shngsk/zmk-config-split-copen/TODO.md

# TODO

## 未解決の問題

なし

## 完了

- [x] **左手デバイス（copen2_L）のキースイッチを押しても何も入力されない**
  - 2026-08-15: 原因判明・解決。
  - **根本原因**: L のバッテリー過放電（電圧 ~1.86V、LiPo 最低動作 3.0V を大幅に下回る）。
    キースキャンは動作するが BLE 広告に必要な大電流を供給できず、L が R に接続できなかった。
  - **対処**: L を USB 給電で使用。バッテリー充電を試みる。回復しない場合はバッテリー交換。
  - **注意**: L が BLE 接続できない場合はまず USB を繋いで動作確認すること。
  - 診断過程で判明した副次的知見:
    - L ハードウェア正常（`copen2_L_standalone` で実機確認済み）
    - `copen2_L.conf` に `CONFIG_BT_CTLR_TX_PWR_PLUS_8=y` を追加（R 側は元々設定済み）

- [x] **USB接続時、Layer 3 の Y キー（BT_SEL 0）を押すと `y` が入力されてしまう**
  - 2026-08-10: 症状改善を確認。完了扱いとする。
  - 右手(copen2_R)のBLE再接続不可の問題を `settings_reset.uf2` 書き込み＋
    PC側の古いペアリング削除で解消した際に、あわせて改善したと思われる
    （詳細な原因切り分けは未実施）。再発したら詳細調査を再開する。
