shngsk/zmk-config-split-copen/(commit log)

2026-01-18 add led config
2026-01-18 Fix board name for Zephyr 4.1.0
2026-01-19 Create right shied's pcb data file
    [copen_right.kicad_pcb, copen_right.kicad_sch]
2026-08-07 Add KiCad PCB design files and update .gitignore
    [EVQWGD001_extension.kicad_pcb, EVQWGD001_extension.kicad_sch, copen_right.kicad_pcb, copen_right.kicad_sch, pmw3610_breakout_for_roBa.kicad_pcb, pmw3610_breakout_for_roBa.kicad_sch, roba_L.kicad_pcb, roba_L.kicad_sch]
2026-08-08 Redesign keymap: mnemonic symbols, numpad, ESC on thumb
    - Layer 0: F16 → lt 4 ESC (tap=ESC, hold=BT layer)
    - Layer 0: Remove layer4_ESC combo; keep S+D=Tab combo
    - Layer 1: テンキー(右手 7-9/4-6/1-3, 0=H) + Fキー(左手 F1-F12)
    DEL = Layer1中にBSタップ
    - Layer 2: ニーモニック記号配置 (Qiita rall_alice 方式)
    @=A !!=E "=W #=H $=D %=P &=N '=Q ¥=Y \=B ;=S :=C
    ~=T `=G |=V {}=MN ()=UI []=JK +-=L;
    - Layer 3: ナビ・Mac ウィンドウ操作 (変更なし)
    - Layer 4: BT・システム (変更なし)
2026-08-08 Fix RGBLED_WIDGET build: add led-red/green/blue aliases for xiao_ble
    zmk-rgbled-widget requires led-red/green/blue DT aliases.
    xiao_ble board has led0/led1/led2 (red/green/blue on P0.26/P0.30/P0.06)
    but does not expose them under the required alias names.
2026-08-08 Fix board name: seeeduino_xiao_ble -> xiao_ble for ZMK v0.3
2026-08-08 Fix copen2_R for Zephyr 4.1 native PMW3610 driver
    Replace shngsk Kconfig with native Zephyr binding properties:
    - Add zephyr,axis-x/y and zephyr,cpi to overlay
    - Remove CONFIG_PMW3610_* (shngsk-specific) from conf
2026-08-08 Remove zephyr,cpi from overlay (not in current Zephyr binding)
2026-08-08 Fix keymap: close bindings bracket and use &mo 3 for layer switch
2026-08-09 keymap: add output selection keys and outputs.h include
    Add OUT_USB / OUT_BLE bindings to Layer 3 (bottom-right) so USB→BLE
    switching can be done manually. Also include outputs.h header.
2026-08-09 diag: disable ZMK Studio and studio-rpc-usb-uart for USB/BLE diagnosis
    Studio was present from initial commit and used to work, so this is
    likely a ZMK main regression. Removing Studio to isolate whether the
    USB→BLE auto-switching failure is Studio-related or a ZMK regression.
2026-08-09 fix: restore Studio, add BLE experimental connection for reconnect fix
    Root cause revised: power cycle causes BLE to not reconnect (not a
    USB switching issue). Studio is not the culprit.
    CONFIG_ZMK_BLE_EXPERIMENTAL_CONN=y improves BLE reconnection handling
    after power cycle, which also explains the USB-disconnect symptom.
2026-08-09 fix: extend idle sleep timeout to 1h to prevent BLE disconnect on reconnect
    Brief BLE connection on power cycle indicates advertising works but
    connection drops immediately. Hypothesis: sleep kicks in before host
    completes reconnection. Extending timeout from default to 3600000ms (1h).
2026-08-09 diag: disable BLE privacy (RPA) to test static address reconnection
    Brief connect-then-drop pattern suggests RPA resolution failure during
    re-encryption handshake after power cycle. Static address eliminates
    this variable.
2026-08-09 diag: try SMP SC pair only disable for macOS reconnection
    Brief connect-then-drop pattern matches Secure Connections failure
    during re-encryption on power cycle with macOS. Allow legacy pairing
    as fallback. Also enable bond overwrite to avoid storage conflicts.
2026-08-09 diag: save BLE bonds immediately to flash (debounce=0)
    Hypothesis: LTK lost on power cycle because settings save debounce
    (~60s default) expires after power-off. After power cycle, keyboard
    has no LTK while macOS does → security handshake fails → silent drop.
    Keyboard visible in BT list but unconnectable matches this pattern.
2026-08-09 fix: use xiao_ble//zmk board qualifier to enable NVS
    Without //zmk, NVS is not enabled and BLE bonds (LTK) are not
    persisted to flash. This caused BLE to fail reconnecting after
    every power cycle. Also restore conf to original state.
    Root cause identified via ZMK Discord by carrefinho.
    Ref: https://github.com/zmkfirmware/zmk/blob/main/app/boards/seeed/xiao_ble/xiao_ble_zmk_defconfig
2026-08-09 fix: add remaining xiao_ble_zmk_defconfig NVS configs for BLE bond persistence
    Add CONFIG_SETTINGS, CONFIG_USE_DT_CODE_PARTITION, CONFIG_RETAINED_MEM,
    CONFIG_RETENTION, CONFIG_RETENTION_BOOT_MODE, and
    CONFIG_ZMK_BOOTMODE_MAGIC_VALUE_BOOTLOADER_TYPE_ADAFRUIT_NRF52 which were
    present in xiao_ble_zmk_defconfig but missing from the previous commit.
    These are required for BLE LTK persistence across power cycles.
2026-08-09 refactor: switch to xiao_ble//zmk to load zmk_defconfig automatically
    NVS configs are now supplied by xiao_ble_zmk_defconfig via the //zmk
    qualifier. Manually duplicated NVS block removed from copen2_R.conf.
    CONFIG_HW_STACK_PROTECTION=n added to both sides to prevent CI failure.
2026-08-10 Fix CI: add artifact-name to keep xiao_ble//zmk in build.yaml
    The v0.3 ZMK reusable workflow (build-user-config.yml) doesn't sanitize
    slashes in the board name when constructing artifact filenames, causing
    'cp: cannot create regular file ...xiao_ble//zmk-zmk.uf2' failures. This
    is fixed on ZMK's main branch (${board//\//_}) but not yet released in
    a tag. Adding explicit artifact-name per build.yaml entry works around
    it while keeping xiao_ble//zmk as recommended on the ZMK Discord.
    Also updates CLAUDE.md to reflect the current approach (xiao_ble//zmk +
    CONFIG_HW_STACK_PROTECTION=n, replacing the old xiao_ble + manual NVS
    conf workaround that's no longer in use).
2026-08-10 Confirm NVS/BLE bond persistence works after settings_reset + re-pair
    Verified on hardware: after switching to xiao_ble//zmk, copen2_R lost
    BLE connectivity (visible in scan but connection failed) due to stale
    bond data from the old partition layout. Flashing settings_reset.uf2
    and re-pairing (with the old PC-side pairing removed) fixed it, and
    power-cycle reconnect now works as intended.
2026-08-12 fix: add wakeup-source to kscan for proper deep sleep wake
    copen2's kscan lacked wakeup-source unlike official split shields (Corne
    etc.). Without it, key presses cannot wake the device from deep sleep.
2026-08-12 docs: update investigation notes for left-hand device issue
    Summarize findings from the diagnostic session:
    - L hardware is confirmed good (standalone USB test)
    - L-R BLE connection and GATT notify are working
    - Root cause is narrowed to R-side processing
    - Next step: capture R-side USB serial log
2026-08-15 fix: close L-key issue (battery), add TX power boost to copen2_L
    L のキー無反応の根本原因はバッテリー過放電（~1.86V）と判明。
    USB 給電で動作することを確認。
    - CLAUDE.md / TODO.md: 調査結果を記録し未解決タスクをクローズ
    - copen2_L.conf: CONFIG_BT_CTLR_TX_PWR_PLUS_8=y を追加（R 側と統一）
